tasminkhan/Low-Cost-Seismic-Monitoring-Device/PCB/bottomcopperMIRROR.PDF

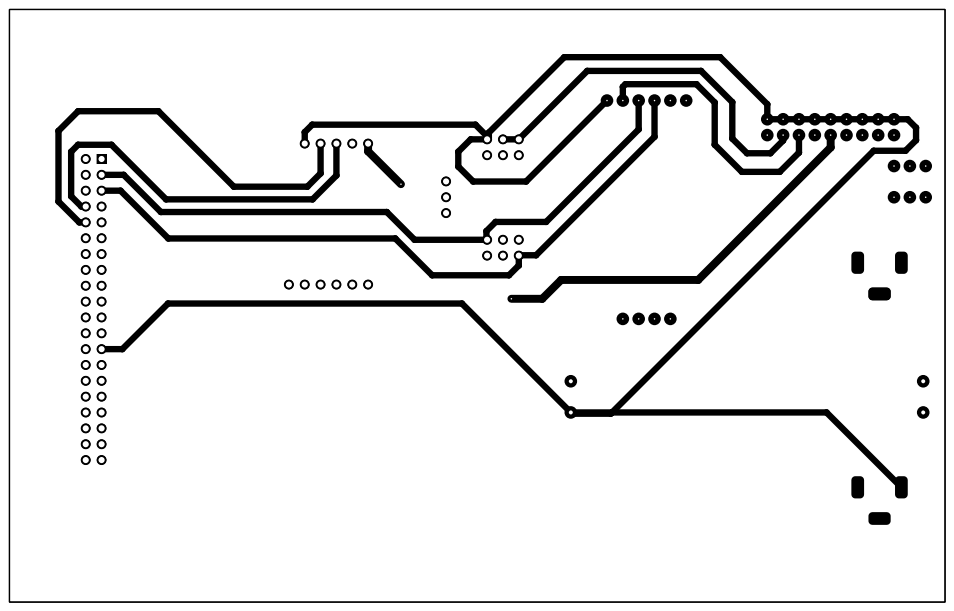
[picture p66: page 1]
