tasminkhan/Low-Cost-Seismic-Monitoring-Device/PCB/topcopperNORMAL.PDF

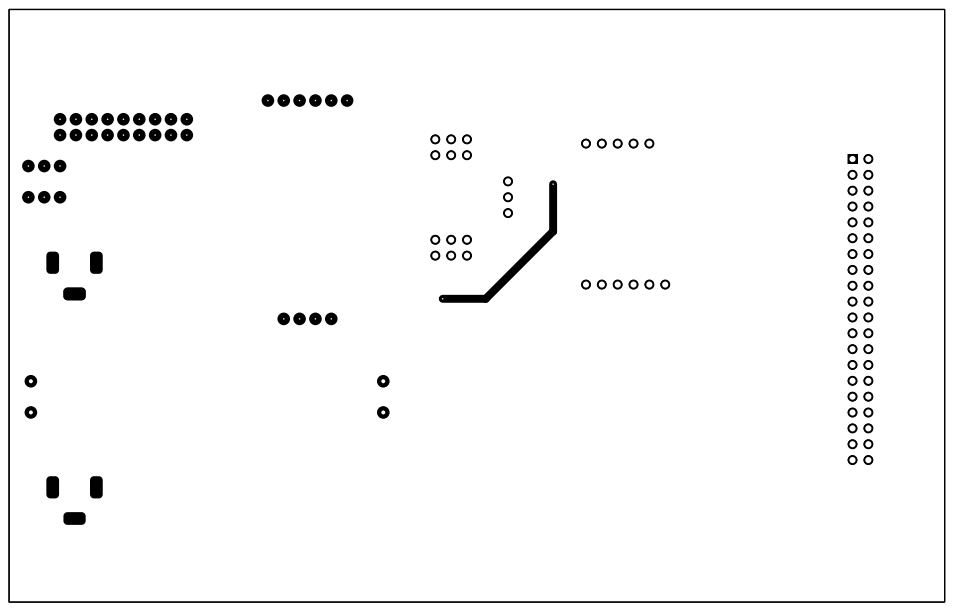
[picture p67: page 1]
