tasminkhan/Low-Cost-Seismic-Monitoring-Device/PCB/topsilkNORMAL.PDF

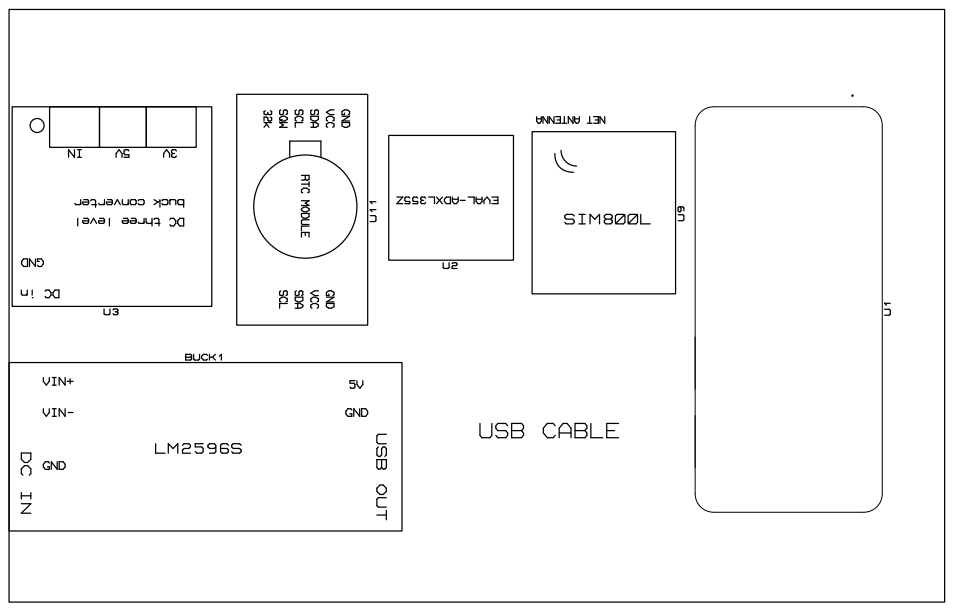
[picture p68: page 1]
